TheStaticTurtle/catears/cad/v4-rev-2/ear_assembly.SLDASM

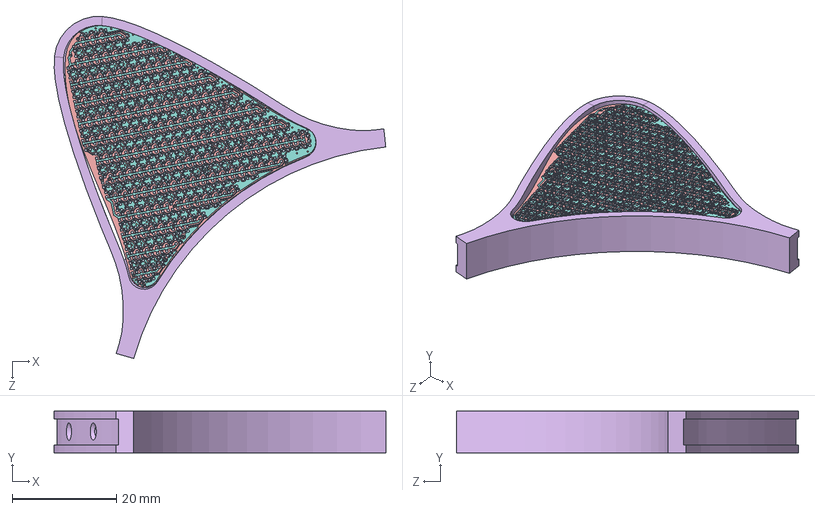
[picture p2: CAD file, 2026-10-26]
cad/v4-rev-2/ear_assembly.SLDASM
63.7 x 8.00 x 65.7 mm
L_Wurth_WE-LQSH-4020-0.step
pcb_a 1.32.1.step
HTSSOP-14-1EP_4.4x5mm_P0.65mm_EP3.4x5mm_Mask3x3.1mm.step
Crystal_SMD_3225-4Pin_3.2x2.5mm_HandSoldering.step
C_0603_1608Metric.step x 18
SOIC-8_5.3x5.3mm_P1.27mm.step
R_0603_1608Metric.step x 16
7466302R_thin.step
DFN-10-1EP_3x3mm_P0.5mm_EP1.55x2.48mm.step
InvenSense_ICS-43434-6_3.5x2.65mm.step
L_0603_1608Metric.step
7466302R_thin_halved.step
Johanson_2450AT43F0100.step
SOT-23.step
D_SMA.step
pcb_a_copper.step
pcb_a_pad.step
pcb_a_via.step
pcb_a_silkscreen.step
pcb_a_soldermask.step
pcb_a_PCB.step
ear
