TheStaticTurtle/catears/cad/v4-rev-2/ear.SLDPRT

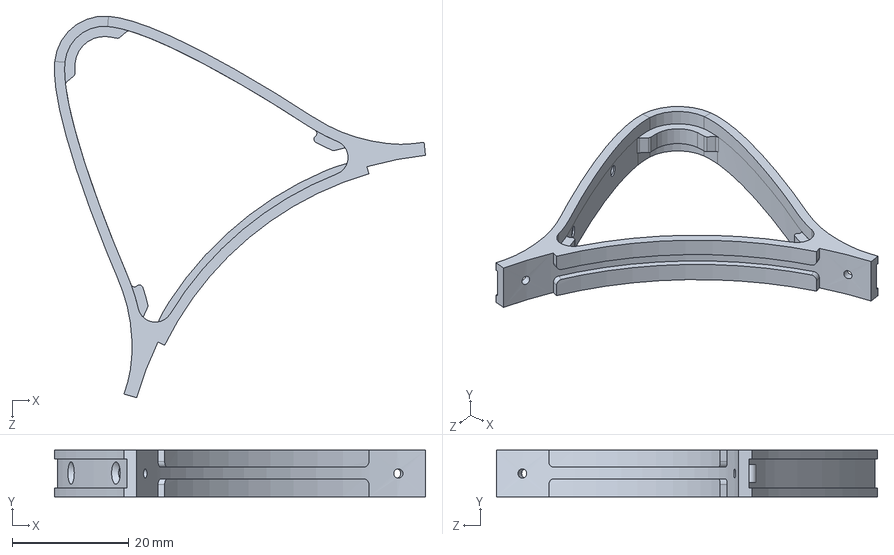
[picture p4: CAD file, 2026-10-26]
cad/v4-rev-2/ear.SLDPRT
63.5 x 8.00 x 65.3 mm
