TheStaticTurtle/catears/cad/v4-rev-3/headband.SLDPRT

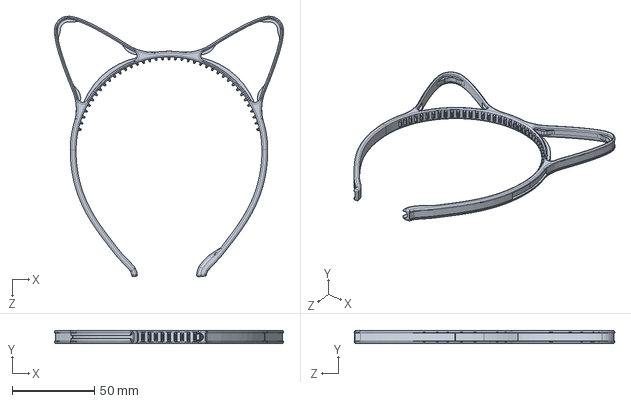
[picture p5: CAD file, 2026-10-26]
cad/v4-rev-3/headband.SLDPRT
139.2 x 8.00 x 158.3 mm
