TheStaticTurtle/catears/electronics/pcb_a_rev3/fabrication/pcb_a_rev3-Edge_Cuts.dxf

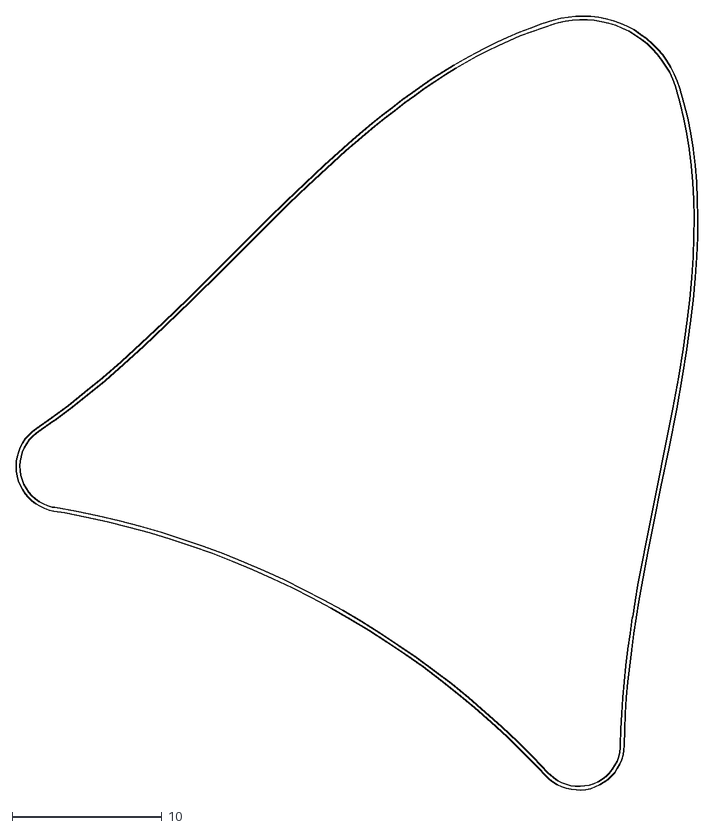
[picture p6: CAD file, 2026-10-26]
electronics/pcb_a_rev3/fabrication/pcb_a_rev3-Edge_Cuts.dxf
45.5 x 51.6
