TheStaticTurtle/catears/cad/v4-rev-2/band.SLDPRT

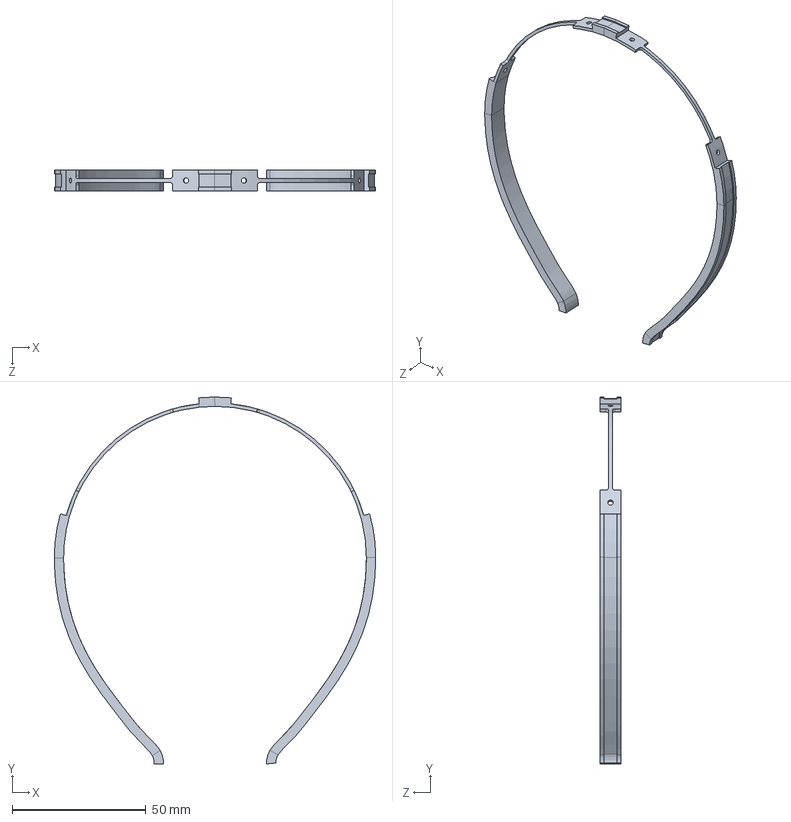
[picture p7: CAD file, 2026-10-26]
cad/v4-rev-2/band.SLDPRT
120.0 x 137.0 x 8.00 mm
