TheStaticTurtle/catears/(list of files, cad)

Other CAD files:
cad/v4-rev-3/assembly.SLDASM
electronics/pcb_b_rev3/fabrication/pcb_b.step
electronics/pcb_a_rev3/fabrication/pcb_a.step
cad/v2-rev-2/catearsv2_2.SLDPRT
electronics/pcb_a_rev2/pcb_a.step
electronics/pcb_a_rev2/L_Wurth_WE-LQSH-4020-0.step.SLDPRT
electronics/pcb_a_rev2/pcb_a 1.32.1.step.SLDPRT
cad/v4-rev-2/ear.STL
cad/v4-rev-3/headband.STL
