TheStaticTurtle/catears/electronics/pcb_a_rev2/pcb_a.kicad_pcb

## KiCad design electronics/pcb_a_rev2/pcb_a.kicad_pcb (2026-10-26, an earlier design)

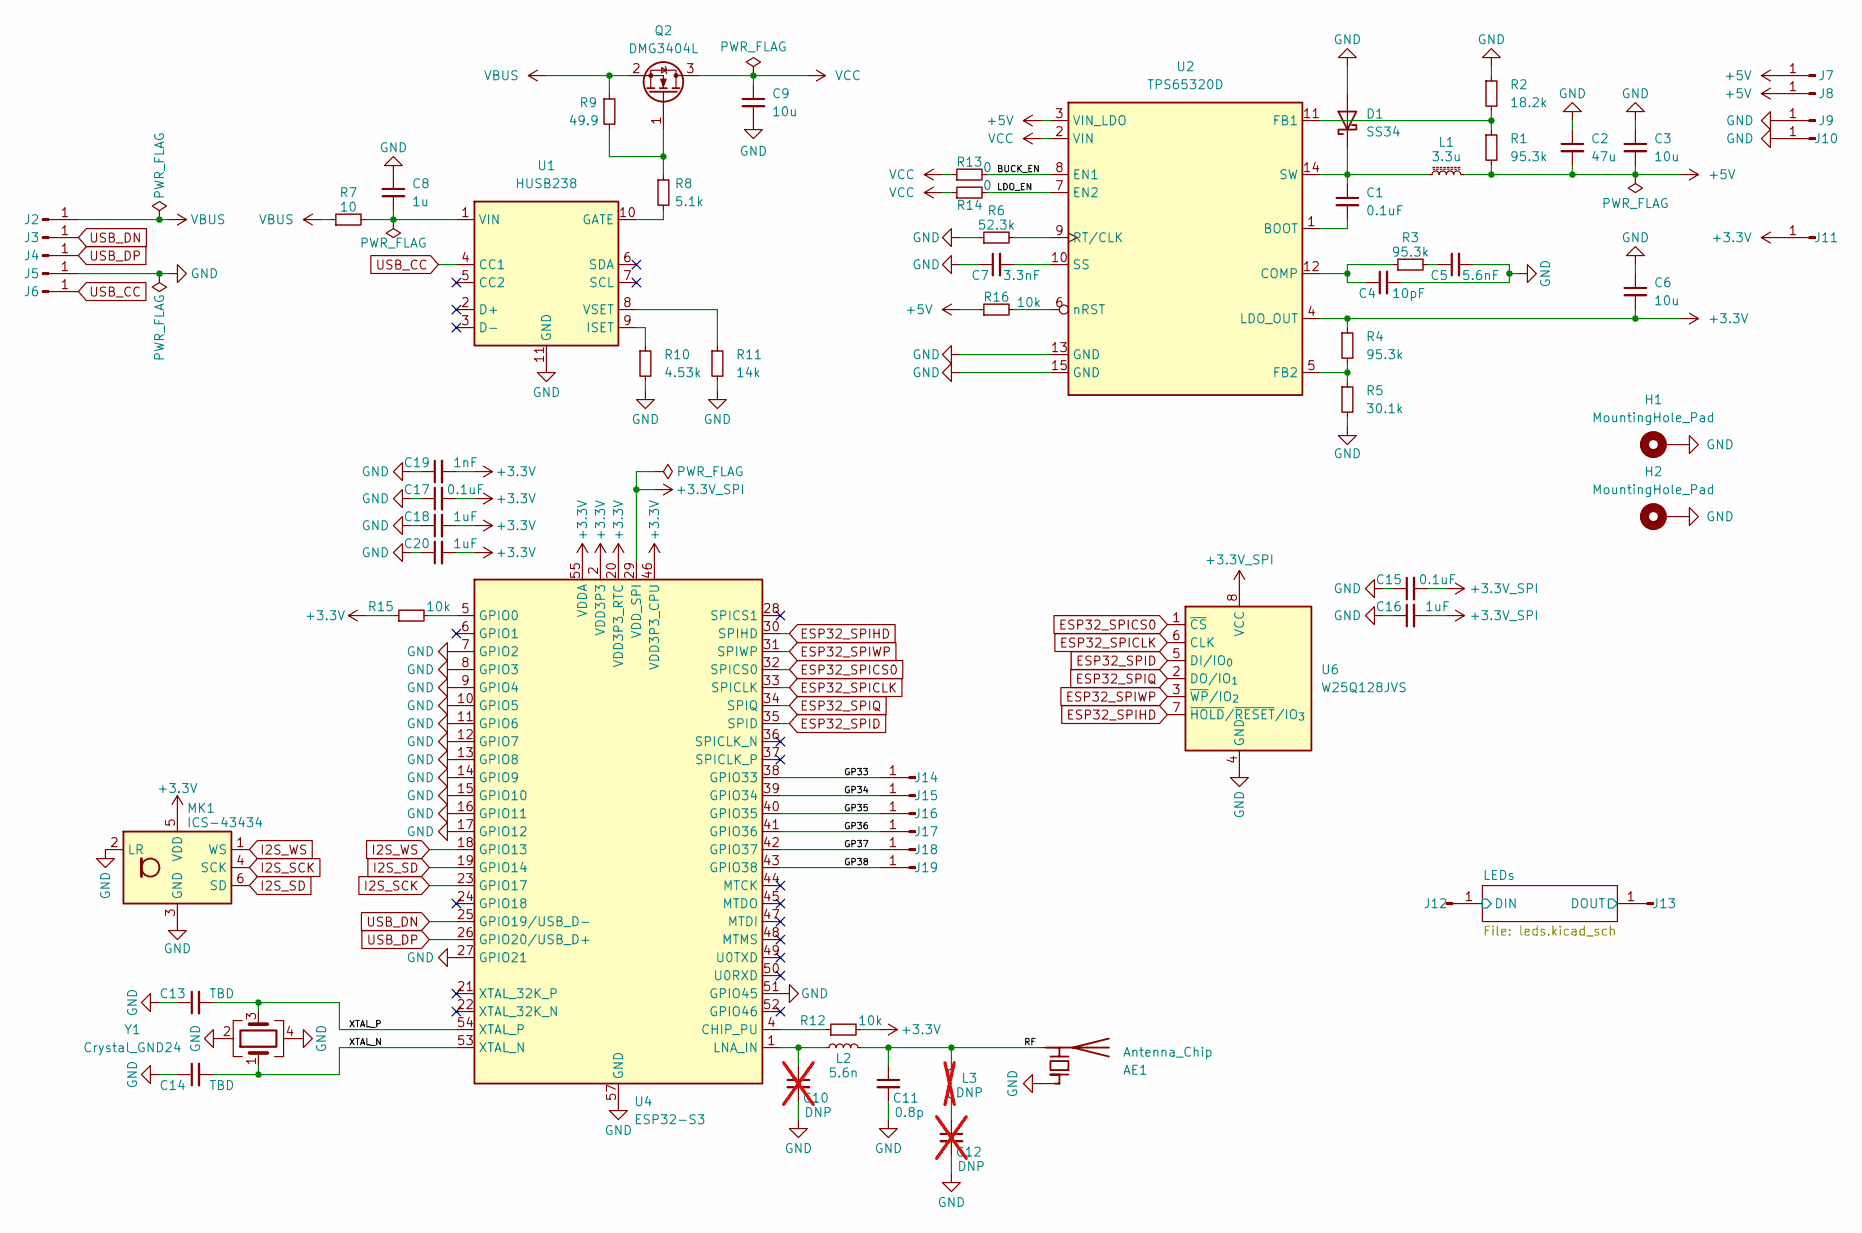
[picture p8: schematic pcb_a.kicad_sch, CatearsV4]

Parts:
AE1: Antenna_Chip; Johanson_2450AT43F0100
C1, C15, C17: 0.1uF; C_0603_1608Metric
C2: 47u; C_0603_1608Metric
C3, C6, C9: 10u; C_0603_1608Metric
C4: 10pF; C_0603_1608Metric
C5: 5.6nF; C_0603_1608Metric
C7: 3.3nF; C_0603_1608Metric
C8: 1u; C_0603_1608Metric
C10, C12: DNP; C_0603_1608Metric; not fitted
C11: 0.8p; C_0603_1608Metric
C13, C14: TBD; C_0603_1608Metric
C16, C18, C20: 1uF; C_0603_1608Metric
C19: 1nF; C_0603_1608Metric
D1: SS34; D_SMA
H1: MountingHole_Pad; 7466302R_thin
H2: MountingHole_Pad; 7466302R_thin_halved
J2, J3, J4, J5, J6, J7, J8, J9, J10, J11, J12, J13, J14, J15, J16, J17, J18, J19: Conn_01x01_Pin; TestPoint_Pad_1.5x1.5mm
L1: 3.3u; L_Wurth_WE-LQSH-4020
L2: 5.6n; L_0603_1608Metric
L3: DNP; L_0603_1608Metric; not fitted
MK1: ICS-43434; InvenSense_ICS-43434-6_3.5x2.65mm
Q2: DMG3404L; SOT-23
R1, R3, R4: 95.3k; R_0603_1608Metric
R2: 18.2k; R_0603_1608Metric
R5: 30.1k; R_0603_1608Metric
R6: 52.3k; R_0603_1608Metric
R7: 10; R_0603_1608Metric
R8: 5.1k; R_0603_1608Metric
R9: 49.9; R_0603_1608Metric
R10: 4.53k; R_0603_1608Metric
R11: 14k; R_0603_1608Metric
R12, R15, R16: 10k; R_0603_1608Metric
R13, R14: 0; R_0603_1608Metric
U1: HUSB238; DFN-10-1EP_3x3mm_P0.5mm_EP1.58x2.35mm
U2: TPS65320D; HTSSOP-14-1EP_4.4x5mm_P0.65mm_EP3.4x5mm_Mask3x3.1mm
U4: ESP32-S3; QFN-56-1EP_7x7mm_P0.4mm_EP4x4mm
U6: W25Q128JVS; SOIC-8_5.3x5.3mm_P1.27mm
Y1: Crystal_GND24; Crystal_SMD_5032-4Pin_5.0x3.2mm

Connections:
+3.3V: C6.2, C17.2, C18.2, C19.2, C20.2, J11.1, MK1.5 (VDD), R4.1, R12.2, R15.1, U2.4 (LDO_OUT), U4.2 (VDD3P3), U4.3 (VDD3P3), U4.20 (VDD3P3_RTC), U4.46 (VDD3P3_CPU), U4.55 (VDDA), U4.56 (VDDA)
+3.3V_SPI: C15.2, C16.2, U4.29 (VDD_SPI), U6.8 (VCC)
+5V: C2.2, C3.2, J7.1, J8.1, L1.2, R1.2, R16.1, U2.3 (VIN_LDO); also elsewhere on the board
/BUCK_EN: R13.2, U2.8 (EN1)
/GP33: J14.1, U4.38 (GPIO33)
/GP34: J15.1, U4.39 (GPIO34)
/GP35: J16.1, U4.40 (GPIO35)
/GP36: J17.1, U4.41 (GPIO36)
/GP37: J18.1, U4.42 (GPIO37)
/GP38: J19.1, U4.43 (GPIO38)
/LDO_EN: R14.2, U2.7 (EN2)
/LEDs/DIN: J12.1; also elsewhere on the board
/LEDs/DOUT: J13.1; also elsewhere on the board
/RF: AE1.2 (PCB_Trace), C11.1, L2.2, L3.2
/XTAL_N: C14.2, U4.53 (XTAL_N), Y1.1
/XTAL_P: C13.2, U4.54 (XTAL_P), Y1.3
ESP32_SPICLK: U4.33 (SPICLK), U6.6 (CLK)
ESP32_SPICS0: U4.32 (SPICS0), U6.1 (~CS)
ESP32_SPID: U4.35 (SPID), U6.5 (DI/IO_{0})
ESP32_SPIHD: U4.30 (SPIHD), U6.7 (~HOLD/~RESET/IO_{3})
ESP32_SPIQ: U4.34 (SPIQ), U6.2 (DO/IO_{1})
ESP32_SPIWP: U4.31 (SPIWP), U6.3 (~WP/IO_{2})
GND: AE1.1 (FEED), C2.1, C3.1, C4.2, C5.2, C6.1, C7.1, C8.1, C9.2, C10.2, C11.2, C12.2, C13.1, C14.1, C15.1, C16.1, C17.1, C18.1, C19.1, C20.1, D1.2 (A), H1.1, H2.1, J5.1, J9.1, J10.1, MK1.2 (LR), MK1.3 (GND), R2.1, R5.2, R6.1, R10.2, R11.2, U1.11 (GND), U2.13 (GND), U2.15 (GND), U4.7 (GPIO2), U4.8 (GPIO3), U4.9 (GPIO4), U4.10 (GPIO5), U4.11 (GPIO6), U4.12 (GPIO7), U4.13 (GPIO8), U4.14 (GPIO9), U4.15 (GPIO10), U4.16 (GPIO11), U4.17 (GPIO12), U4.27 (GPIO21), U4.51 (GPIO45), U4.57 (GND), U6.4 (GND), Y1.2, Y1.4; also elsewhere on the board
I2S_SCK: MK1.4 (SCK), U4.23 (GPIO17)
I2S_SD: MK1.6 (SD), U4.19 (GPIO14)
I2S_WS: MK1.1 (WS), U4.18 (GPIO13)
unnamed: C5.1, R3.2
unnamed: C12.1, L3.1
unnamed: C1.1, D1.1 (K), L1.1, U2.14 (SW)
unnamed: Q2.1 (G), R8.1, R9.2
unnamed: R8.2, U1.10 (GATE)
unnamed: R10.1, U1.9 (ISET)
unnamed: C8.2, R7.2, U1.1 (VIN)
unnamed: R11.1, U1.8 (VSET)
unnamed: C1.2, U2.1 (BOOT)
unnamed: C4.1, R3.1, U2.12 (COMP)
unnamed: R1.1, R2.2, U2.11 (FB1)
unnamed: R4.2, R5.1, U2.5 (FB2)
unnamed: R6.2, U2.9 (RT/CLK)
unnamed: C7.2, U2.10 (SS)
unnamed: R16.2, U2.6 (nRST)
unnamed: R12.1, U4.4 (CHIP_PU)
unnamed: R15.2, U4.5 (GPIO0)
unnamed: C10.1, L2.1, U4.1 (LNA_IN)
USB_CC: J6.1, U1.4 (CC1)
USB_DN: J3.1, U4.25 (GPIO19/USB_D-)
USB_DP: J4.1, U4.26 (GPIO20/USB_D+)
VBUS: J2.1, Q2.2 (S), R7.1, R9.1
VCC: C9.1, Q2.3 (D), R13.1, R14.1, U2.2 (VIN)

Schematic: leds.kicad_sch

Parts:
D2, D3, D4, D5, D6, D7, D8, D9, D10, D11, D12, D13, D14, D15, D16, D17, D18, D19, D20, D21, D22, D23, D24, D25, D26, D27, D28, D29, D30, D31, D32, D33, D34, D35, D36, D37, D38, D39, D40, D41, D42, D43, D44, D45, D46, D47, D48, D49, D50, D51, D52, D53, D54, D55, D56, D57, D58, D59, D60, D61, D62, D63, D64, D65, D66, D67, D68, D69, D70, D71, D72, D73, D74, D75, D76, D77, D78, D79, D80, D81, D82, D83, D84, D85, D86, D87, D88, D89, D90, D91, D92, D93, D94, D95, D96, D97, D98, D99, D100, D101, D102, D103, D104, D105, D106, D107, D108, D109, D110, D111, D112, D113, D114, D115, D116, D117, D118, D119, D120, D121, D122, D123, D124, D125, D126, D127, D128, D129, D130, D131, D132, D133, D134, D135, D136, D137, D138, D139, D140, D141, D142, D143, D144, D145, D146, D147, D148, D149, D150, D151, D152, D153, D154, D155, D156, D157, D158, D159, D160, D161, D162, D163, D164, D165, D166, D167, D168, D169, D170, D171, D172, D173, D174, D175, D176, D177, D178, D179, D180, D181, D182, D183, D184, D185, D186, D187, D188, D189, D190, D191, D192, D193, D194, D195, D196, D197, D198, D199, D200, D201, D202, D203, D204, D205, D206, D207, D208, D209, D210, D211, D212, D213, D214, D215, D216, D217, D218, D219, D220, D221, D222, D223, D224, D225, D226, D227, D228, D229, D230, D231, D232, D233, D234, D235, D236, D237, D238, D239, D240, D241, D242, D243, D244, D245, D246, D247, D248, D249, D250, D251, D252, D253, D254, D255, D257, D258, D259, D260, D261, D262, D263, D264, D265, D266, D267, D268, D269, D270, D271, D272, D273, D274, D275, D276, D277, D278, D279, D280, D281, D282, D283, D284, D285, D286, D287, D288, D289, D290, D291, D292, D293, D294, D295, D296, D297, D298, D299, D300, D301, D302, D303, D304, D305, D306, D307, D308, D309, D310, D311, D312, D313, D314, D315, D316, D317, D318, D319, D320, D321, D322, D323, D324, D325, D326, D327, D328: XL-1010; XL-1010RGBC

Connections:
+5V: D2.2 (VDD), D3.2 (VDD), D4.2 (VDD), D5.2 (VDD), D6.2 (VDD), D7.2 (VDD), D8.2 (VDD), D9.2 (VDD), D10.2 (VDD), D11.2 (VDD), D12.2 (VDD), D13.2 (VDD), D14.2 (VDD), D15.2 (VDD), D16.2 (VDD), D17.2 (VDD), D18.2 (VDD), D19.2 (VDD), D20.2 (VDD), D21.2 (VDD), D22.2 (VDD), D23.2 (VDD), D24.2 (VDD), D25.2 (VDD), D26.2 (VDD), D27.2 (VDD), D28.2 (VDD), D29.2 (VDD), D30.2 (VDD), D31.2 (VDD), D32.2 (VDD), D33.2 (VDD), D34.2 (VDD), D35.2 (VDD), D36.2 (VDD), D37.2 (VDD), D38.2 (VDD), D39.2 (VDD), D40.2 (VDD), D41.2 (VDD), D42.2 (VDD), D43.2 (VDD), D44.2 (VDD), D45.2 (VDD), D46.2 (VDD), D47.2 (VDD), D48.2 (VDD), D49.2 (VDD), D50.2 (VDD), D51.2 (VDD), D52.2 (VDD), D53.2 (VDD), D54.2 (VDD), D55.2 (VDD), D56.2 (VDD), D57.2 (VDD), D58.2 (VDD), D59.2 (VDD), D60.2 (VDD), D61.2 (VDD), D62.2 (VDD), D63.2 (VDD), D64.2 (VDD), D65.2 (VDD), D66.2 (VDD), D67.2 (VDD), D68.2 (VDD), D69.2 (VDD), D70.2 (VDD), D71.2 (VDD), D72.2 (VDD), D73.2 (VDD), D74.2 (VDD), D75.2 (VDD), D76.2 (VDD), D77.2 (VDD), D78.2 (VDD), D79.2 (VDD), D80.2 (VDD), D81.2 (VDD), D82.2 (VDD), D83.2 (VDD), D84.2 (VDD), D85.2 (VDD), D86.2 (VDD), D87.2 (VDD), D88.2 (VDD), D89.2 (VDD), D90.2 (VDD), D91.2 (VDD), D92.2 (VDD), D93.2 (VDD), D94.2 (VDD), D95.2 (VDD), D96.2 (VDD), D97.2 (VDD), D98.2 (VDD), D99.2 (VDD), D100.2 (VDD), D101.2 (VDD), D102.2 (VDD), D103.2 (VDD), D104.2 (VDD), D105.2 (VDD), D106.2 (VDD), D107.2 (VDD), D108.2 (VDD), D109.2 (VDD), D110.2 (VDD), D111.2 (VDD), D112.2 (VDD), D113.2 (VDD), D114.2 (VDD), D115.2 (VDD), D116.2 (VDD), D117.2 (VDD), D118.2 (VDD), D119.2 (VDD), D120.2 (VDD), D121.2 (VDD), D122.2 (VDD), D123.2 (VDD), D124.2 (VDD), D125.2 (VDD), D126.2 (VDD), D127.2 (VDD), D128.2 (VDD), D129.2 (VDD), D130.2 (VDD), D131.2 (VDD), D132.2 (VDD), D133.2 (VDD), D134.2 (VDD), D135.2 (VDD), D136.2 (VDD), D137.2 (VDD), D138.2 (VDD), D139.2 (VDD), D140.2 (VDD), D141.2 (VDD), D142.2 (VDD), D143.2 (VDD), D144.2 (VDD), D145.2 (VDD), D146.2 (VDD), D147.2 (VDD), D148.2 (VDD), D149.2 (VDD), D150.2 (VDD), D151.2 (VDD), D152.2 (VDD), D153.2 (VDD), D154.2 (VDD), D155.2 (VDD), D156.2 (VDD), D157.2 (VDD), D158.2 (VDD), D159.2 (VDD), D160.2 (VDD), D161.2 (VDD), D162.2 (VDD), D163.2 (VDD), D164.2 (VDD), D165.2 (VDD), D166.2 (VDD), D167.2 (VDD), D168.2 (VDD), D169.2 (VDD), D170.2 (VDD), D171.2 (VDD), D172.2 (VDD), D173.2 (VDD), D174.2 (VDD), D175.2 (VDD), D176.2 (VDD), D177.2 (VDD), D178.2 (VDD), D179.2 (VDD), D180.2 (VDD), D181.2 (VDD), D182.2 (VDD), D183.2 (VDD), D184.2 (VDD), D185.2 (VDD), D186.2 (VDD), D187.2 (VDD), D188.2 (VDD), D189.2 (VDD), D190.2 (VDD), D191.2 (VDD), D192.2 (VDD), D193.2 (VDD), D194.2 (VDD), D195.2 (VDD), D196.2 (VDD), D197.2 (VDD), D198.2 (VDD), D199.2 (VDD), D200.2 (VDD), D201.2 (VDD), D202.2 (VDD), D203.2 (VDD), D204.2 (VDD), D205.2 (VDD), D206.2 (VDD), D207.2 (VDD), D208.2 (VDD), D209.2 (VDD), D210.2 (VDD), D211.2 (VDD), D212.2 (VDD), D213.2 (VDD), D214.2 (VDD), D215.2 (VDD), D216.2 (VDD), D217.2 (VDD), D218.2 (VDD), D219.2 (VDD), D220.2 (VDD), D221.2 (VDD), D222.2 (VDD), D223.2 (VDD), D224.2 (VDD), D225.2 (VDD), D226.2 (VDD), D227.2 (VDD), D228.2 (VDD), D229.2 (VDD), D230.2 (VDD), D231.2 (VDD), D232.2 (VDD), D233.2 (VDD), D234.2 (VDD), D235.2 (VDD), D236.2 (VDD), D237.2 (VDD), D238.2 (VDD), D239.2 (VDD), D240.2 (VDD), D241.2 (VDD), D242.2 (VDD), D243.2 (VDD), D244.2 (VDD), D245.2 (VDD), D246.2 (VDD), D247.2 (VDD), D248.2 (VDD), D249.2 (VDD), D250.2 (VDD), D251.2 (VDD), D252.2 (VDD), D253.2 (VDD), D254.2 (VDD), D255.2 (VDD), D257.2 (VDD), D258.2 (VDD), D259.2 (VDD), D260.2 (VDD), D261.2 (VDD), D262.2 (VDD), D263.2 (VDD), D264.2 (VDD), D265.2 (VDD), D266.2 (VDD), D267.2 (VDD), D268.2 (VDD), D269.2 (VDD), D270.2 (VDD), D271.2 (VDD), D272.2 (VDD), D273.2 (VDD), D274.2 (VDD), D275.2 (VDD), D276.2 (VDD), D277.2 (VDD), D278.2 (VDD), D279.2 (VDD), D280.2 (VDD), D281.2 (VDD), D282.2 (VDD), D283.2 (VDD), D284.2 (VDD), D285.2 (VDD), D286.2 (VDD), D287.2 (VDD), D288.2 (VDD), D289.2 (VDD), D290.2 (VDD), D291.2 (VDD), D292.2 (VDD), D293.2 (VDD), D294.2 (VDD), D295.2 (VDD), D296.2 (VDD), D297.2 (VDD), D298.2 (VDD), D299.2 (VDD), D300.2 (VDD), D301.2 (VDD), D302.2 (VDD), D303.2 (VDD), D304.2 (VDD), D305.2 (VDD), D306.2 (VDD), D307.2 (VDD), D308.2 (VDD), D309.2 (VDD), D310.2 (VDD), D311.2 (VDD), D312.2 (VDD), D313.2 (VDD), D314.2 (VDD), D315.2 (VDD), D316.2 (VDD), D317.2 (VDD), D318.2 (VDD), D319.2 (VDD), D320.2 (VDD), D321.2 (VDD), D322.2 (VDD), D323.2 (VDD), D324.2 (VDD), D325.2 (VDD), D326.2 (VDD), D327.2 (VDD), D328.2 (VDD); also elsewhere on the board
/LEDs/DIN: D2.4 (DIN); also elsewhere on the board
/LEDs/DOUT: D328.1 (DOUT); also elsewhere on the board
GND: D2.3 (VSS), D3.3 (VSS), D4.3 (VSS), D5.3 (VSS), D6.3 (VSS), D7.3 (VSS), D8.3 (VSS), D9.3 (VSS), D10.3 (VSS), D11.3 (VSS), D12.3 (VSS), D13.3 (VSS), D14.3 (VSS), D15.3 (VSS), D16.3 (VSS), D17.3 (VSS), D18.3 (VSS), D19.3 (VSS), D20.3 (VSS), D21.3 (VSS), D22.3 (VSS), D23.3 (VSS), D24.3 (VSS), D25.3 (VSS), D26.3 (VSS), D27.3 (VSS), D28.3 (VSS), D29.3 (VSS), D30.3 (VSS), D31.3 (VSS), D32.3 (VSS), D33.3 (VSS), D34.3 (VSS), D35.3 (VSS), D36.3 (VSS), D37.3 (VSS), D38.3 (VSS), D39.3 (VSS), D40.3 (VSS), D41.3 (VSS), D42.3 (VSS), D43.3 (VSS), D44.3 (VSS), D45.3 (VSS), D46.3 (VSS), D47.3 (VSS), D48.3 (VSS), D49.3 (VSS), D50.3 (VSS), D51.3 (VSS), D52.3 (VSS), D53.3 (VSS), D54.3 (VSS), D55.3 (VSS), D56.3 (VSS), D57.3 (VSS), D58.3 (VSS), D59.3 (VSS), D60.3 (VSS), D61.3 (VSS), D62.3 (VSS), D63.3 (VSS), D64.3 (VSS), D65.3 (VSS), D66.3 (VSS), D67.3 (VSS), D68.3 (VSS), D69.3 (VSS), D70.3 (VSS), D71.3 (VSS), D72.3 (VSS), D73.3 (VSS), D74.3 (VSS), D75.3 (VSS), D76.3 (VSS), D77.3 (VSS), D78.3 (VSS), D79.3 (VSS), D80.3 (VSS), D81.3 (VSS), D82.3 (VSS), D83.3 (VSS), D84.3 (VSS), D85.3 (VSS), D86.3 (VSS), D87.3 (VSS), D88.3 (VSS), D89.3 (VSS), D90.3 (VSS), D91.3 (VSS), D92.3 (VSS), D93.3 (VSS), D94.3 (VSS), D95.3 (VSS), D96.3 (VSS), D97.3 (VSS), D98.3 (VSS), D99.3 (VSS), D100.3 (VSS), D101.3 (VSS), D102.3 (VSS), D103.3 (VSS), D104.3 (VSS), D105.3 (VSS), D106.3 (VSS), D107.3 (VSS), D108.3 (VSS), D109.3 (VSS), D110.3 (VSS), D111.3 (VSS), D112.3 (VSS), D113.3 (VSS), D114.3 (VSS), D115.3 (VSS), D116.3 (VSS), D117.3 (VSS), D118.3 (VSS), D119.3 (VSS), D120.3 (VSS), D121.3 (VSS), D122.3 (VSS), D123.3 (VSS), D124.3 (VSS), D125.3 (VSS), D126.3 (VSS), D127.3 (VSS), D128.3 (VSS), D129.3 (VSS), D130.3 (VSS), D131.3 (VSS), D132.3 (VSS), D133.3 (VSS), D134.3 (VSS), D135.3 (VSS), D136.3 (VSS), D137.3 (VSS), D138.3 (VSS), D139.3 (VSS), D140.3 (VSS), D141.3 (VSS), D142.3 (VSS), D143.3 (VSS), D144.3 (VSS), D145.3 (VSS), D146.3 (VSS), D147.3 (VSS), D148.3 (VSS), D149.3 (VSS), D150.3 (VSS), D151.3 (VSS), D152.3 (VSS), D153.3 (VSS), D154.3 (VSS), D155.3 (VSS), D156.3 (VSS), D157.3 (VSS), D158.3 (VSS), D159.3 (VSS), D160.3 (VSS), D161.3 (VSS), D162.3 (VSS), D163.3 (VSS), D164.3 (VSS), D165.3 (VSS), D166.3 (VSS), D167.3 (VSS), D168.3 (VSS), D169.3 (VSS), D170.3 (VSS), D171.3 (VSS), D172.3 (VSS), D173.3 (VSS), D174.3 (VSS), D175.3 (VSS), D176.3 (VSS), D177.3 (VSS), D178.3 (VSS), D179.3 (VSS), D180.3 (VSS), D181.3 (VSS), D182.3 (VSS), D183.3 (VSS), D184.3 (VSS), D185.3 (VSS), D186.3 (VSS), D187.3 (VSS), D188.3 (VSS), D189.3 (VSS), D190.3 (VSS), D191.3 (VSS), D192.3 (VSS), D193.3 (VSS), D194.3 (VSS), D195.3 (VSS), D196.3 (VSS), D197.3 (VSS), D198.3 (VSS), D199.3 (VSS), D200.3 (VSS), D201.3 (VSS), D202.3 (VSS), D203.3 (VSS), D204.3 (VSS), D205.3 (VSS), D206.3 (VSS), D207.3 (VSS), D208.3 (VSS), D209.3 (VSS), D210.3 (VSS), D211.3 (VSS), D212.3 (VSS), D213.3 (VSS), D214.3 (VSS), D215.3 (VSS), D216.3 (VSS), D217.3 (VSS), D218.3 (VSS), D219.3 (VSS), D220.3 (VSS), D221.3 (VSS), D222.3 (VSS), D223.3 (VSS), D224.3 (VSS), D225.3 (VSS), D226.3 (VSS), D227.3 (VSS), D228.3 (VSS), D229.3 (VSS), D230.3 (VSS), D231.3 (VSS), D232.3 (VSS), D233.3 (VSS), D234.3 (VSS), D235.3 (VSS), D236.3 (VSS), D237.3 (VSS), D238.3 (VSS), D239.3 (VSS), D240.3 (VSS), D241.3 (VSS), D242.3 (VSS), D243.3 (VSS), D244.3 (VSS), D245.3 (VSS), D246.3 (VSS), D247.3 (VSS), D248.3 (VSS), D249.3 (VSS), D250.3 (VSS), D251.3 (VSS), D252.3 (VSS), D253.3 (VSS), D254.3 (VSS), D255.3 (VSS), D257.3 (VSS), D258.3 (VSS), D259.3 (VSS), D260.3 (VSS), D261.3 (VSS), D262.3 (VSS), D263.3 (VSS), D264.3 (VSS), D265.3 (VSS), D266.3 (VSS), D267.3 (VSS), D268.3 (VSS), D269.3 (VSS), D270.3 (VSS), D271.3 (VSS), D272.3 (VSS), D273.3 (VSS), D274.3 (VSS), D275.3 (VSS), D276.3 (VSS), D277.3 (VSS), D278.3 (VSS), D279.3 (VSS), D280.3 (VSS), D281.3 (VSS), D282.3 (VSS), D283.3 (VSS), D284.3 (VSS), D285.3 (VSS), D286.3 (VSS), D287.3 (VSS), D288.3 (VSS), D289.3 (VSS), D290.3 (VSS), D291.3 (VSS), D292.3 (VSS), D293.3 (VSS), D294.3 (VSS), D295.3 (VSS), D296.3 (VSS), D297.3 (VSS), D298.3 (VSS), D299.3 (VSS), D300.3 (VSS), D301.3 (VSS), D302.3 (VSS), D303.3 (VSS), D304.3 (VSS), D305.3 (VSS), D306.3 (VSS), D307.3 (VSS), D308.3 (VSS), D309.3 (VSS), D310.3 (VSS), D311.3 (VSS), D312.3 (VSS), D313.3 (VSS), D314.3 (VSS), D315.3 (VSS), D316.3 (VSS), D317.3 (VSS), D318.3 (VSS), D319.3 (VSS), D320.3 (VSS), D321.3 (VSS), D322.3 (VSS), D323.3 (VSS), D324.3 (VSS), D325.3 (VSS), D326.3 (VSS), D327.3 (VSS), D328.3 (VSS); also elsewhere on the board
unnamed: D2.1 (DOUT), D3.4 (DIN)
unnamed: D3.1 (DOUT), D4.4 (DIN)
unnamed: D4.1 (DOUT), D5.4 (DIN)
unnamed: D5.1 (DOUT), D6.4 (DIN)
unnamed: D6.1 (DOUT), D7.4 (DIN)
unnamed: D7.1 (DOUT), D8.4 (DIN)
unnamed: D8.1 (DOUT), D9.4 (DIN)
unnamed: D9.1 (DOUT), D10.4 (DIN)
unnamed: D10.1 (DOUT), D11.4 (DIN)
unnamed: D11.1 (DOUT), D12.4 (DIN)
unnamed: D12.1 (DOUT), D13.4 (DIN)
unnamed: D13.1 (DOUT), D14.4 (DIN)
unnamed: D14.1 (DOUT), D15.4 (DIN)
unnamed: D15.1 (DOUT), D16.4 (DIN)
unnamed: D16.1 (DOUT), D17.4 (DIN)
unnamed: D17.1 (DOUT), D18.4 (DIN)
unnamed: D18.1 (DOUT), D19.4 (DIN)
unnamed: D19.1 (DOUT), D20.4 (DIN)
unnamed: D20.1 (DOUT), D21.4 (DIN)
unnamed: D21.1 (DOUT), D22.4 (DIN)
unnamed: D22.1 (DOUT), D23.4 (DIN)
unnamed: D23.1 (DOUT), D24.4 (DIN)
unnamed: D24.1 (DOUT), D25.4 (DIN)
unnamed: D25.1 (DOUT), D26.4 (DIN)
unnamed: D26.1 (DOUT), D27.4 (DIN)
unnamed: D27.1 (DOUT), D28.4 (DIN)
unnamed: D28.1 (DOUT), D29.4 (DIN)
unnamed: D29.1 (DOUT), D30.4 (DIN)
unnamed: D30.1 (DOUT), D31.4 (DIN)
unnamed: D31.1 (DOUT), D32.4 (DIN)
unnamed: D32.1 (DOUT), D33.4 (DIN)
unnamed: D33.1 (DOUT), D34.4 (DIN)
unnamed: D34.1 (DOUT), D35.4 (DIN)
unnamed: D35.1 (DOUT), D36.4 (DIN)
unnamed: D36.1 (DOUT), D37.4 (DIN)
unnamed: D37.1 (DOUT), D38.4 (DIN)
unnamed: D38.1 (DOUT), D39.4 (DIN)
unnamed: D39.1 (DOUT), D40.4 (DIN)
unnamed: D40.1 (DOUT), D41.4 (DIN)
unnamed: D41.1 (DOUT), D42.4 (DIN)
unnamed: D42.1 (DOUT), D43.4 (DIN)
unnamed: D43.1 (DOUT), D44.4 (DIN)
unnamed: D44.1 (DOUT), D45.4 (DIN)
unnamed: D45.1 (DOUT), D46.4 (DIN)
unnamed: D46.1 (DOUT), D47.4 (DIN)
unnamed: D47.1 (DOUT), D48.4 (DIN)
unnamed: D48.1 (DOUT), D49.4 (DIN)
unnamed: D49.1 (DOUT), D50.4 (DIN)
unnamed: D50.1 (DOUT), D51.4 (DIN)
unnamed: D51.1 (DOUT), D52.4 (DIN)
unnamed: D52.1 (DOUT), D53.4 (DIN)
unnamed: D53.1 (DOUT), D54.4 (DIN)
unnamed: D54.1 (DOUT), D55.4 (DIN)
unnamed: D55.1 (DOUT), D56.4 (DIN)
unnamed: D56.1 (DOUT), D57.4 (DIN)
unnamed: D57.1 (DOUT), D58.4 (DIN)
unnamed: D58.1 (DOUT), D59.4 (DIN)
unnamed: D59.1 (DOUT), D60.4 (DIN)
unnamed: D60.1 (DOUT), D61.4 (DIN)
unnamed: D61.1 (DOUT), D62.4 (DIN)
unnamed: D62.1 (DOUT), D63.4 (DIN)
unnamed: D63.1 (DOUT), D64.4 (DIN)
unnamed: D64.1 (DOUT), D65.4 (DIN)
unnamed: D65.1 (DOUT), D66.4 (DIN)
unnamed: D66.1 (DOUT), D67.4 (DIN)
unnamed: D67.1 (DOUT), D68.4 (DIN)
unnamed: D68.1 (DOUT), D69.4 (DIN)
unnamed: D69.1 (DOUT), D70.4 (DIN)
unnamed: D70.1 (DOUT), D71.4 (DIN)
unnamed: D71.1 (DOUT), D72.4 (DIN)
unnamed: D72.1 (DOUT), D73.4 (DIN)
unnamed: D73.1 (DOUT), D74.4 (DIN)
unnamed: D74.1 (DOUT), D75.4 (DIN)
unnamed: D75.1 (DOUT), D76.4 (DIN)
unnamed: D76.1 (DOUT), D77.4 (DIN)
unnamed: D77.1 (DOUT), D78.4 (DIN)
unnamed: D78.1 (DOUT), D79.4 (DIN)
unnamed: D79.1 (DOUT), D80.4 (DIN)
unnamed: D80.1 (DOUT), D81.4 (DIN)
unnamed: D81.1 (DOUT), D82.4 (DIN)
unnamed: D82.1 (DOUT), D83.4 (DIN)
unnamed: D83.1 (DOUT), D84.4 (DIN)
unnamed: D84.1 (DOUT), D85.4 (DIN)
unnamed: D85.1 (DOUT), D86.4 (DIN)
unnamed: D86.1 (DOUT), D87.4 (DIN)
unnamed: D87.1 (DOUT), D88.4 (DIN)
unnamed: D88.1 (DOUT), D89.4 (DIN)
unnamed: D89.1 (DOUT), D90.4 (DIN)
unnamed: D90.1 (DOUT), D91.4 (DIN)
unnamed: D91.1 (DOUT), D92.4 (DIN)
unnamed: D92.1 (DOUT), D93.4 (DIN)
unnamed: D93.1 (DOUT), D94.4 (DIN)
unnamed: D94.1 (DOUT), D95.4 (DIN)
unnamed: D95.1 (DOUT), D96.4 (DIN)
unnamed: D96.1 (DOUT), D97.4 (DIN)
unnamed: D97.1 (DOUT), D98.4 (DIN)
unnamed: D98.1 (DOUT), D99.4 (DIN)
unnamed: D99.1 (DOUT), D100.4 (DIN)
unnamed: D100.1 (DOUT), D101.4 (DIN)
unnamed: D101.1 (DOUT), D102.4 (DIN)
unnamed: D102.1 (DOUT), D103.4 (DIN)
unnamed: D103.1 (DOUT), D104.4 (DIN)
unnamed: D104.1 (DOUT), D105.4 (DIN)
unnamed: D105.1 (DOUT), D106.4 (DIN)
unnamed: D106.1 (DOUT), D107.4 (DIN)
unnamed: D107.1 (DOUT), D108.4 (DIN)
unnamed: D108.1 (DOUT), D109.4 (DIN)
unnamed: D109.1 (DOUT), D110.4 (DIN)
unnamed: D110.1 (DOUT), D111.4 (DIN)
unnamed: D111.1 (DOUT), D112.4 (DIN)
unnamed: D112.1 (DOUT), D113.4 (DIN)
unnamed: D113.1 (DOUT), D114.4 (DIN)
unnamed: D114.1 (DOUT), D115.4 (DIN)
unnamed: D115.1 (DOUT), D116.4 (DIN)
unnamed: D116.1 (DOUT), D117.4 (DIN)
unnamed: D117.1 (DOUT), D118.4 (DIN)
unnamed: D118.1 (DOUT), D119.4 (DIN)
unnamed: D119.1 (DOUT), D120.4 (DIN)
unnamed: D120.1 (DOUT), D121.4 (DIN)
unnamed: D121.1 (DOUT), D122.4 (DIN)
unnamed: D122.1 (DOUT), D123.4 (DIN)
unnamed: D123.1 (DOUT), D124.4 (DIN)
unnamed: D124.1 (DOUT), D125.4 (DIN)
unnamed: D125.1 (DOUT), D126.4 (DIN)
unnamed: D126.1 (DOUT), D127.4 (DIN)
unnamed: D127.1 (DOUT), D128.4 (DIN)
unnamed: D128.1 (DOUT), D129.4 (DIN)
unnamed: D129.1 (DOUT), D130.4 (DIN)
unnamed: D130.1 (DOUT), D131.4 (DIN)
unnamed: D131.1 (DOUT), D132.4 (DIN)
unnamed: D132.1 (DOUT), D133.4 (DIN)
unnamed: D133.1 (DOUT), D134.4 (DIN)
unnamed: D134.1 (DOUT), D135.4 (DIN)
unnamed: D135.1 (DOUT), D136.4 (DIN)
unnamed: D136.1 (DOUT), D137.4 (DIN)
unnamed: D137.1 (DOUT), D138.4 (DIN)
unnamed: D138.1 (DOUT), D139.4 (DIN)
unnamed: D139.1 (DOUT), D140.4 (DIN)
unnamed: D140.1 (DOUT), D141.4 (DIN)
unnamed: D141.1 (DOUT), D142.4 (DIN)
unnamed: D142.1 (DOUT), D143.4 (DIN)
unnamed: D143.1 (DOUT), D144.4 (DIN)
unnamed: D144.1 (DOUT), D145.4 (DIN)
unnamed: D145.1 (DOUT), D146.4 (DIN)
unnamed: D146.1 (DOUT), D147.4 (DIN)
unnamed: D147.1 (DOUT), D148.4 (DIN)
unnamed: D148.1 (DOUT), D149.4 (DIN)
unnamed: D149.1 (DOUT), D150.4 (DIN)
unnamed: D150.1 (DOUT), D151.4 (DIN)
unnamed: D151.1 (DOUT), D152.4 (DIN)
unnamed: D152.1 (DOUT), D153.4 (DIN)
unnamed: D153.1 (DOUT), D154.4 (DIN)
unnamed: D154.1 (DOUT), D155.4 (DIN)
unnamed: D155.1 (DOUT), D156.4 (DIN)
unnamed: D156.1 (DOUT), D157.4 (DIN)
unnamed: D157.1 (DOUT), D158.4 (DIN)
unnamed: D158.1 (DOUT), D159.4 (DIN)
unnamed: D159.1 (DOUT), D160.4 (DIN)
unnamed: D160.1 (DOUT), D161.4 (DIN)
unnamed: D161.1 (DOUT), D162.4 (DIN)
unnamed: D162.1 (DOUT), D163.4 (DIN)
unnamed: D163.1 (DOUT), D164.4 (DIN)
unnamed: D164.1 (DOUT), D165.4 (DIN)
unnamed: D165.1 (DOUT), D166.4 (DIN)
unnamed: D166.1 (DOUT), D167.4 (DIN)
unnamed: D167.1 (DOUT), D168.4 (DIN)
unnamed: D168.1 (DOUT), D169.4 (DIN)
unnamed: D169.1 (DOUT), D170.4 (DIN)
unnamed: D170.1 (DOUT), D171.4 (DIN)
unnamed: D171.1 (DOUT), D172.4 (DIN)
unnamed: D172.1 (DOUT), D173.4 (DIN)
unnamed: D173.1 (DOUT), D174.4 (DIN)
unnamed: D174.1 (DOUT), D175.4 (DIN)
unnamed: D175.1 (DOUT), D176.4 (DIN)
unnamed: D176.1 (DOUT), D177.4 (DIN)
unnamed: D177.1 (DOUT), D178.4 (DIN)
unnamed: D178.1 (DOUT), D179.4 (DIN)
unnamed: D179.1 (DOUT), D180.4 (DIN)
unnamed: D180.1 (DOUT), D181.4 (DIN)
unnamed: D181.1 (DOUT), D182.4 (DIN)
unnamed: D182.1 (DOUT), D183.4 (DIN)
unnamed: D183.1 (DOUT), D184.4 (DIN)
unnamed: D184.1 (DOUT), D185.4 (DIN)
unnamed: D185.1 (DOUT), D186.4 (DIN)
unnamed: D186.1 (DOUT), D187.4 (DIN)
unnamed: D187.1 (DOUT), D188.4 (DIN)
unnamed: D188.1 (DOUT), D189.4 (DIN)
unnamed: D189.1 (DOUT), D190.4 (DIN)
unnamed: D190.1 (DOUT), D191.4 (DIN)
unnamed: D191.1 (DOUT), D192.4 (DIN)
unnamed: D192.1 (DOUT), D193.4 (DIN)
unnamed: D193.1 (DOUT), D194.4 (DIN)
unnamed: D194.1 (DOUT), D195.4 (DIN)
unnamed: D195.1 (DOUT), D196.4 (DIN)
unnamed: D196.1 (DOUT), D197.4 (DIN)
unnamed: D197.1 (DOUT), D198.4 (DIN)
unnamed: D198.1 (DOUT), D199.4 (DIN)
unnamed: D199.1 (DOUT), D200.4 (DIN)
unnamed: D200.1 (DOUT), D201.4 (DIN)
unnamed: D201.1 (DOUT), D202.4 (DIN)
unnamed: D202.1 (DOUT), D203.4 (DIN)
unnamed: D203.1 (DOUT), D204.4 (DIN)
unnamed: D204.1 (DOUT), D205.4 (DIN)
unnamed: D205.1 (DOUT), D206.4 (DIN)
unnamed: D206.1 (DOUT), D207.4 (DIN)
unnamed: D207.1 (DOUT), D208.4 (DIN)
unnamed: D208.1 (DOUT), D209.4 (DIN)
unnamed: D209.1 (DOUT), D210.4 (DIN)
unnamed: D210.1 (DOUT), D211.4 (DIN)
unnamed: D211.1 (DOUT), D212.4 (DIN)
unnamed: D212.1 (DOUT), D213.4 (DIN)
unnamed: D213.1 (DOUT), D214.4 (DIN)
unnamed: D214.1 (DOUT), D215.4 (DIN)
unnamed: D215.1 (DOUT), D216.4 (DIN)
unnamed: D216.1 (DOUT), D217.4 (DIN)
unnamed: D217.1 (DOUT), D218.4 (DIN)
unnamed: D218.1 (DOUT), D219.4 (DIN)
unnamed: D219.1 (DOUT), D220.4 (DIN)
unnamed: D220.1 (DOUT), D221.4 (DIN)
unnamed: D221.1 (DOUT), D222.4 (DIN)
unnamed: D222.1 (DOUT), D223.4 (DIN)
unnamed: D223.1 (DOUT), D224.4 (DIN)
unnamed: D224.1 (DOUT), D225.4 (DIN)
unnamed: D225.1 (DOUT), D226.4 (DIN)
unnamed: D226.1 (DOUT), D227.4 (DIN)
unnamed: D227.1 (DOUT), D228.4 (DIN)
unnamed: D228.1 (DOUT), D229.4 (DIN)
unnamed: D229.1 (DOUT), D230.4 (DIN)
unnamed: D230.1 (DOUT), D231.4 (DIN)
unnamed: D231.1 (DOUT), D232.4 (DIN)
unnamed: D232.1 (DOUT), D233.4 (DIN)
unnamed: D233.1 (DOUT), D234.4 (DIN)
unnamed: D234.1 (DOUT), D235.4 (DIN)
unnamed: D235.1 (DOUT), D236.4 (DIN)
unnamed: D236.1 (DOUT), D237.4 (DIN)
unnamed: D237.1 (DOUT), D238.4 (DIN)
unnamed: D238.1 (DOUT), D239.4 (DIN)
unnamed: D239.1 (DOUT), D240.4 (DIN)
unnamed: D240.1 (DOUT), D241.4 (DIN)
unnamed: D241.1 (DOUT), D242.4 (DIN)
unnamed: D242.1 (DOUT), D243.4 (DIN)
unnamed: D243.1 (DOUT), D244.4 (DIN)
unnamed: D244.1 (DOUT), D245.4 (DIN)
unnamed: D245.1 (DOUT), D246.4 (DIN)
unnamed: D246.1 (DOUT), D247.4 (DIN)
unnamed: D247.1 (DOUT), D248.4 (DIN)
unnamed: D248.1 (DOUT), D249.4 (DIN)
unnamed: D249.1 (DOUT), D250.4 (DIN)
unnamed: D250.1 (DOUT), D251.4 (DIN)
unnamed: D251.1 (DOUT), D252.4 (DIN)
unnamed: D252.1 (DOUT), D253.4 (DIN)
unnamed: D253.1 (DOUT), D254.4 (DIN)
unnamed: D254.1 (DOUT), D255.4 (DIN)
unnamed: D255.1 (DOUT), D257.4 (DIN)
unnamed: D257.1 (DOUT), D258.4 (DIN)
unnamed: D258.1 (DOUT), D259.4 (DIN)
unnamed: D259.1 (DOUT), D260.4 (DIN)
unnamed: D260.1 (DOUT), D261.4 (DIN)
unnamed: D261.1 (DOUT), D262.4 (DIN)
unnamed: D262.1 (DOUT), D263.4 (DIN)
unnamed: D263.1 (DOUT), D264.4 (DIN)
unnamed: D264.1 (DOUT), D265.4 (DIN)
unnamed: D265.1 (DOUT), D266.4 (DIN)
unnamed: D266.1 (DOUT), D267.4 (DIN)
unnamed: D267.1 (DOUT), D268.4 (DIN)
unnamed: D268.1 (DOUT), D269.4 (DIN)
unnamed: D269.1 (DOUT), D270.4 (DIN)
unnamed: D270.1 (DOUT), D271.4 (DIN)
unnamed: D271.1 (DOUT), D272.4 (DIN)
unnamed: D272.1 (DOUT), D273.4 (DIN)
unnamed: D273.1 (DOUT), D274.4 (DIN)
unnamed: D274.1 (DOUT), D275.4 (DIN)
unnamed: D275.1 (DOUT), D276.4 (DIN)
unnamed: D276.1 (DOUT), D277.4 (DIN)
unnamed: D277.1 (DOUT), D278.4 (DIN)
unnamed: D278.1 (DOUT), D279.4 (DIN)
unnamed: D279.1 (DOUT), D280.4 (DIN)
unnamed: D280.1 (DOUT), D281.4 (DIN)
unnamed: D281.1 (DOUT), D282.4 (DIN)
unnamed: D282.1 (DOUT), D283.4 (DIN)
unnamed: D283.1 (DOUT), D284.4 (DIN)
unnamed: D284.1 (DOUT), D285.4 (DIN)
unnamed: D285.1 (DOUT), D286.4 (DIN)
unnamed: D286.1 (DOUT), D287.4 (DIN)
unnamed: D287.1 (DOUT), D288.4 (DIN)
unnamed: D288.1 (DOUT), D289.4 (DIN)
unnamed: D289.1 (DOUT), D290.4 (DIN)
unnamed: D290.1 (DOUT), D291.4 (DIN)
unnamed: D291.1 (DOUT), D292.4 (DIN)
unnamed: D292.1 (DOUT), D293.4 (DIN)
unnamed: D293.1 (DOUT), D294.4 (DIN)
unnamed: D294.1 (DOUT), D295.4 (DIN)
unnamed: D295.1 (DOUT), D296.4 (DIN)
unnamed: D296.1 (DOUT), D297.4 (DIN)
unnamed: D297.1 (DOUT), D298.4 (DIN)
unnamed: D298.1 (DOUT), D299.4 (DIN)
unnamed: D299.1 (DOUT), D300.4 (DIN)
unnamed: D300.1 (DOUT), D301.4 (DIN)
unnamed: D301.1 (DOUT), D302.4 (DIN)
unnamed: D302.1 (DOUT), D303.4 (DIN)
unnamed: D303.1 (DOUT), D304.4 (DIN)
unnamed: D304.1 (DOUT), D305.4 (DIN)
unnamed: D305.1 (DOUT), D306.4 (DIN)
unnamed: D306.1 (DOUT), D307.4 (DIN)
unnamed: D307.1 (DOUT), D308.4 (DIN)
unnamed: D308.1 (DOUT), D309.4 (DIN)
unnamed: D309.1 (DOUT), D310.4 (DIN)
unnamed: D310.1 (DOUT), D311.4 (DIN)
unnamed: D311.1 (DOUT), D312.4 (DIN)
unnamed: D312.1 (DOUT), D313.4 (DIN)
unnamed: D313.1 (DOUT), D314.4 (DIN)
unnamed: D314.1 (DOUT), D315.4 (DIN)
unnamed: D315.1 (DOUT), D316.4 (DIN)
unnamed: D316.1 (DOUT), D317.4 (DIN)
unnamed: D317.1 (DOUT), D318.4 (DIN)
unnamed: D318.1 (DOUT), D319.4 (DIN)
unnamed: D319.1 (DOUT), D320.4 (DIN)
unnamed: D320.1 (DOUT), D321.4 (DIN)
unnamed: D321.1 (DOUT), D322.4 (DIN)
unnamed: D322.1 (DOUT), D323.4 (DIN)
unnamed: D323.1 (DOUT), D324.4 (DIN)
unnamed: D324.1 (DOUT), D325.4 (DIN)
unnamed: D325.1 (DOUT), D326.4 (DIN)
unnamed: D326.1 (DOUT), D327.4 (DIN)
unnamed: D327.1 (DOUT), D328.4 (DIN)

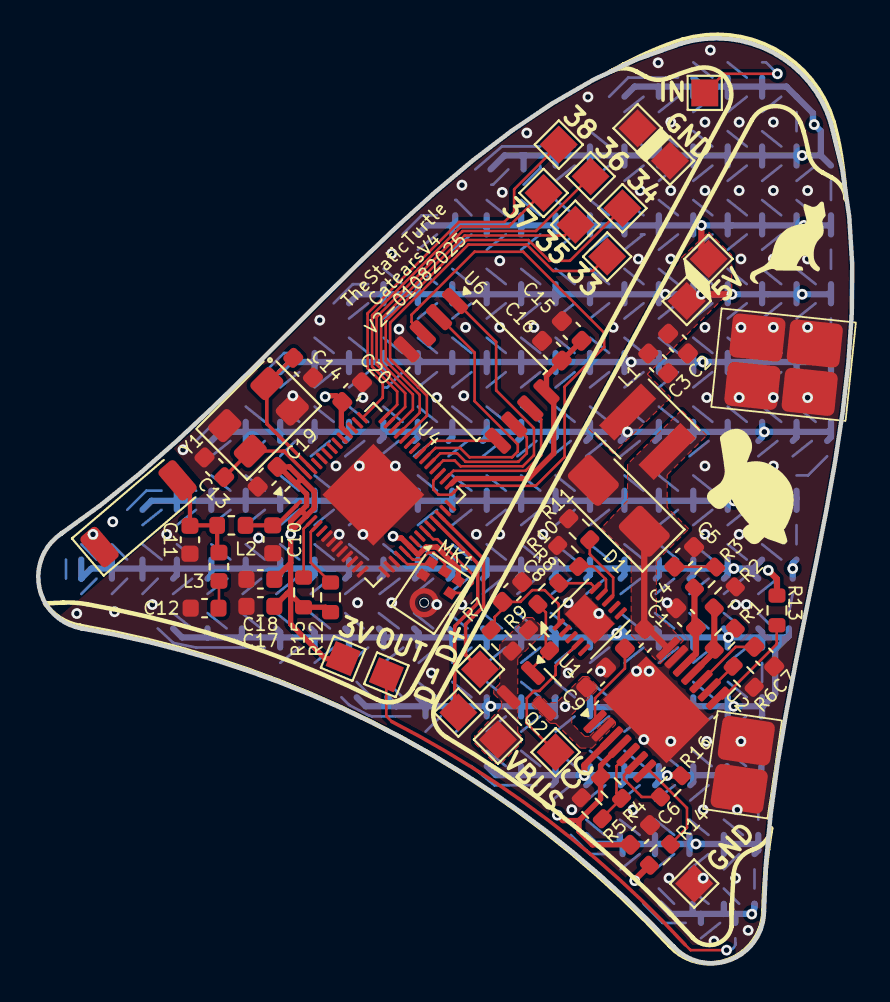
[picture p9: board pcb_a.kicad_pcb from above]

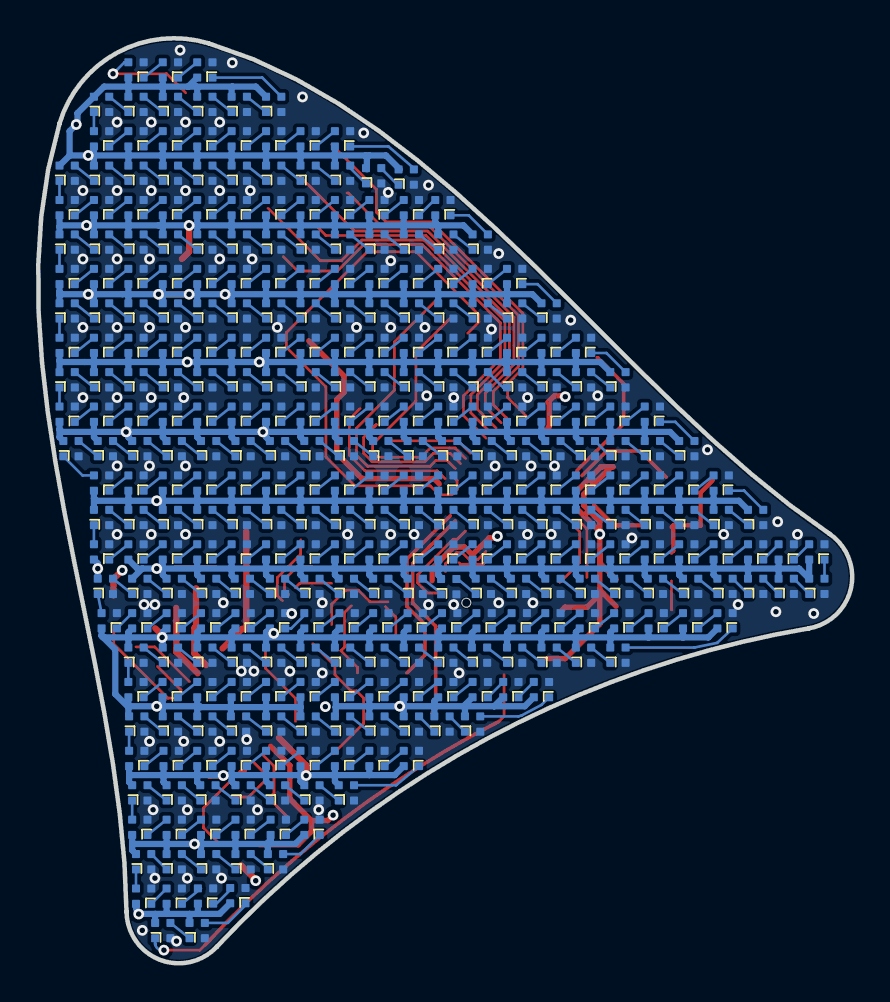
[picture p10: board pcb_a.kicad_pcb from below]

Board: 4 copper layers, 45.2 x 51.4 mm, 394 parts (326 on the bottom side), 374 nets.
